abdelrhman1040/Digital-Electronic-Power-Load/Images/schematic/+3V3.png

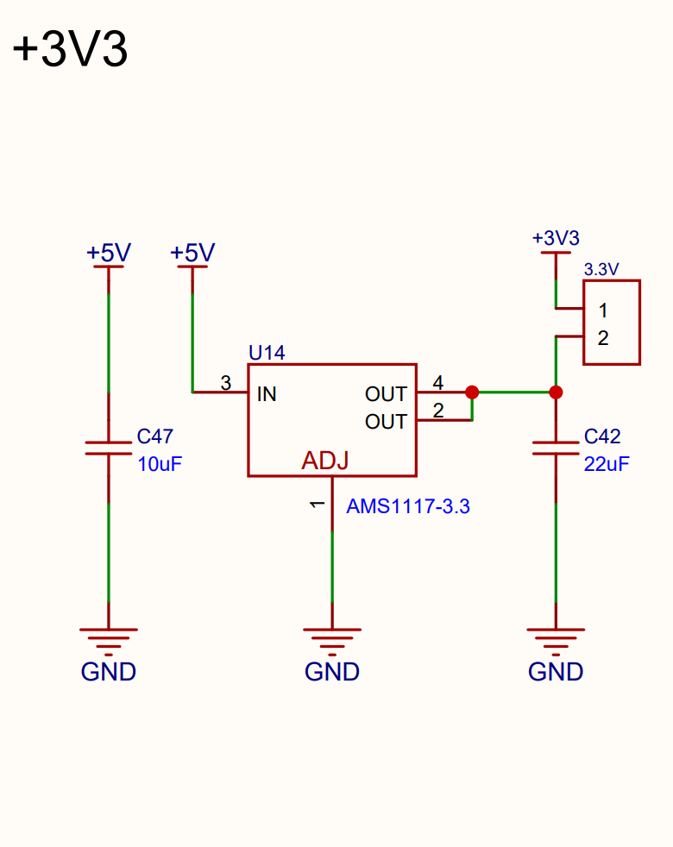
Images/schematic/+3V3.png
