abdelrhman1040/Digital-Electronic-Power-Load/Images/schematic/+5V.png

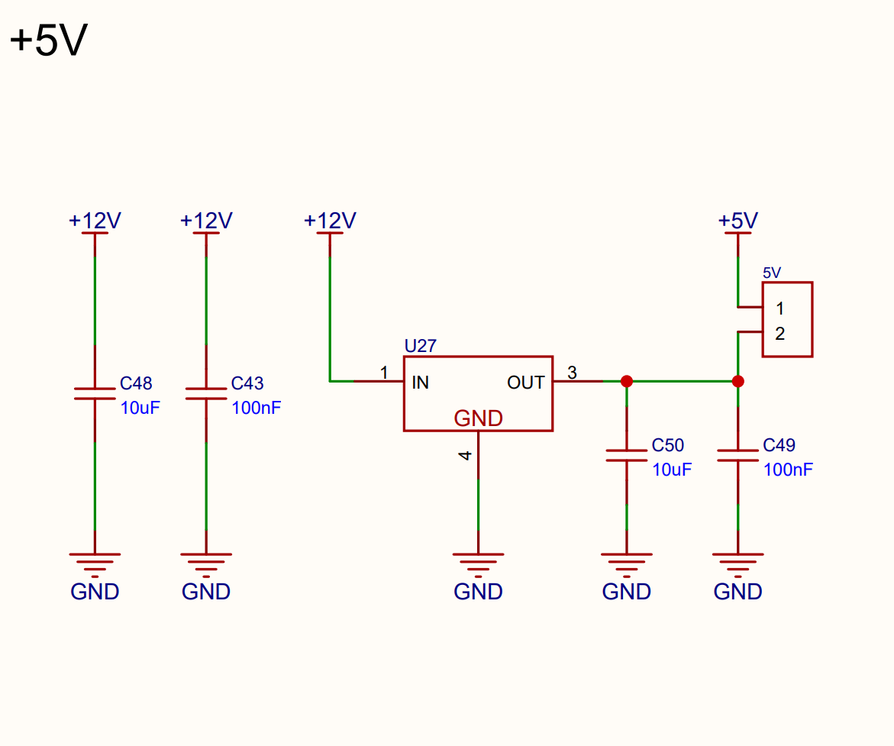
Images/schematic/+5V.png
