abdelrhman1040/Digital-Electronic-Power-Load/Images/schematic/DC.png

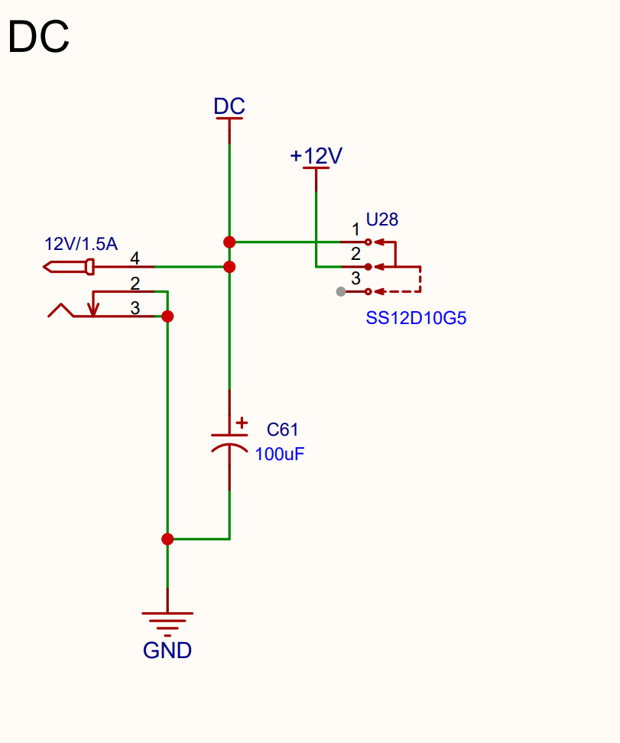
Images/schematic/DC.png
