abdelrhman1040/Digital-Electronic-Power-Load/Images/schematic/LEDs.png

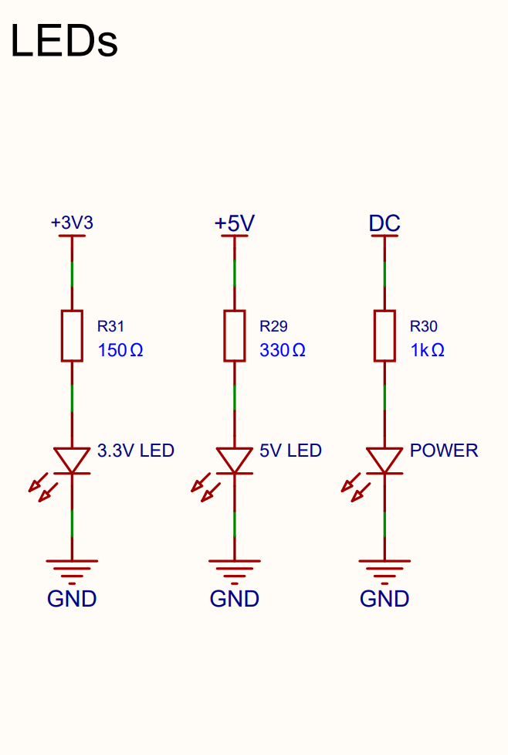
Images/schematic/LEDs.png
