abdelrhman1040/Digital-Electronic-Power-Load/Images/schematic/power_stage.png

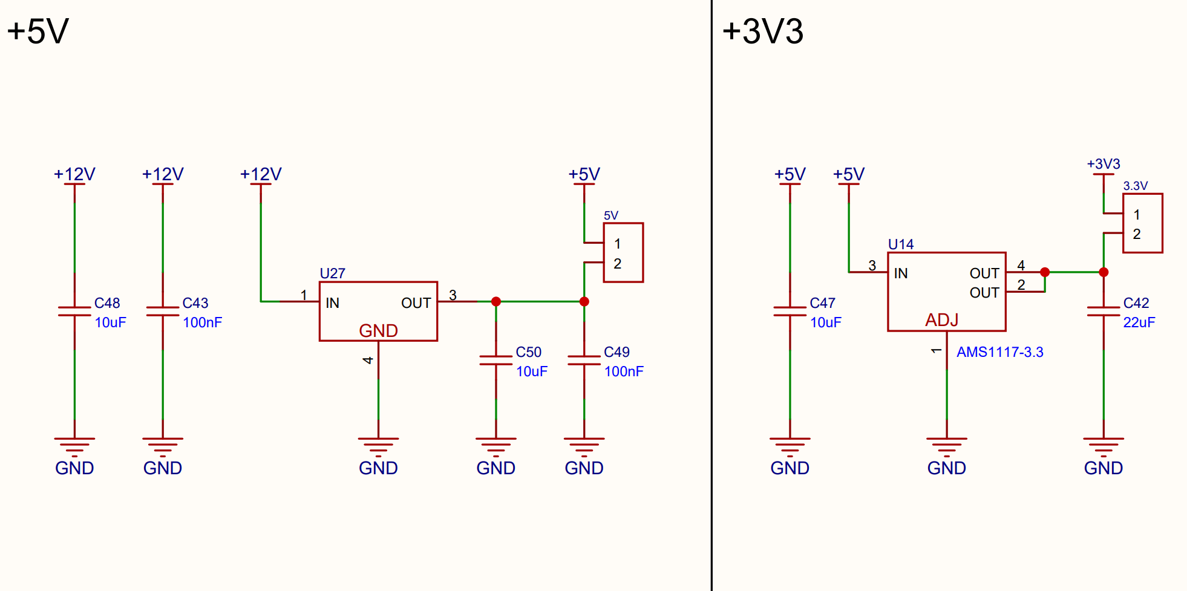
Images/schematic/power_stage.png
