abdelrhman1040/Digital-Electronic-Power-Load/Images/schematic/SD_Card.png

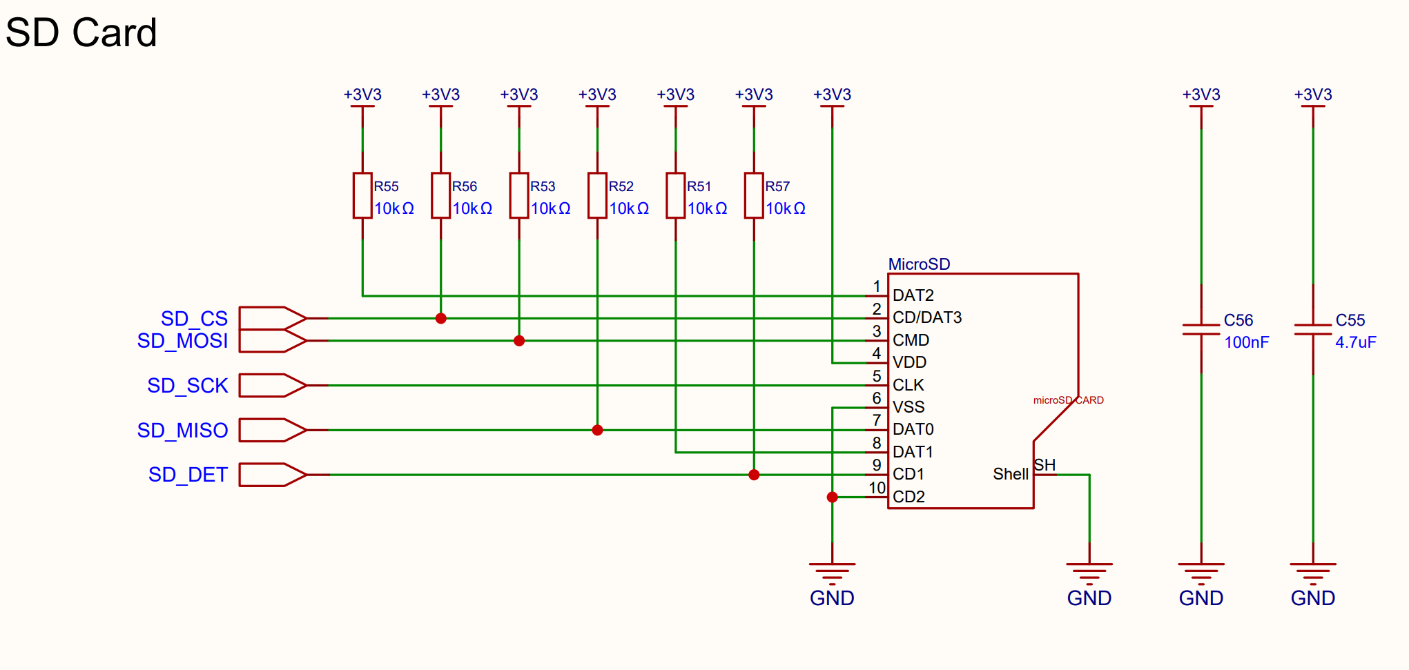
Images/schematic/SD_Card.png
