abdelrhman1040/Digital-Electronic-Power-Load/Hardware/schematic/Schematic.pdf

# STM32

# GNDVIN

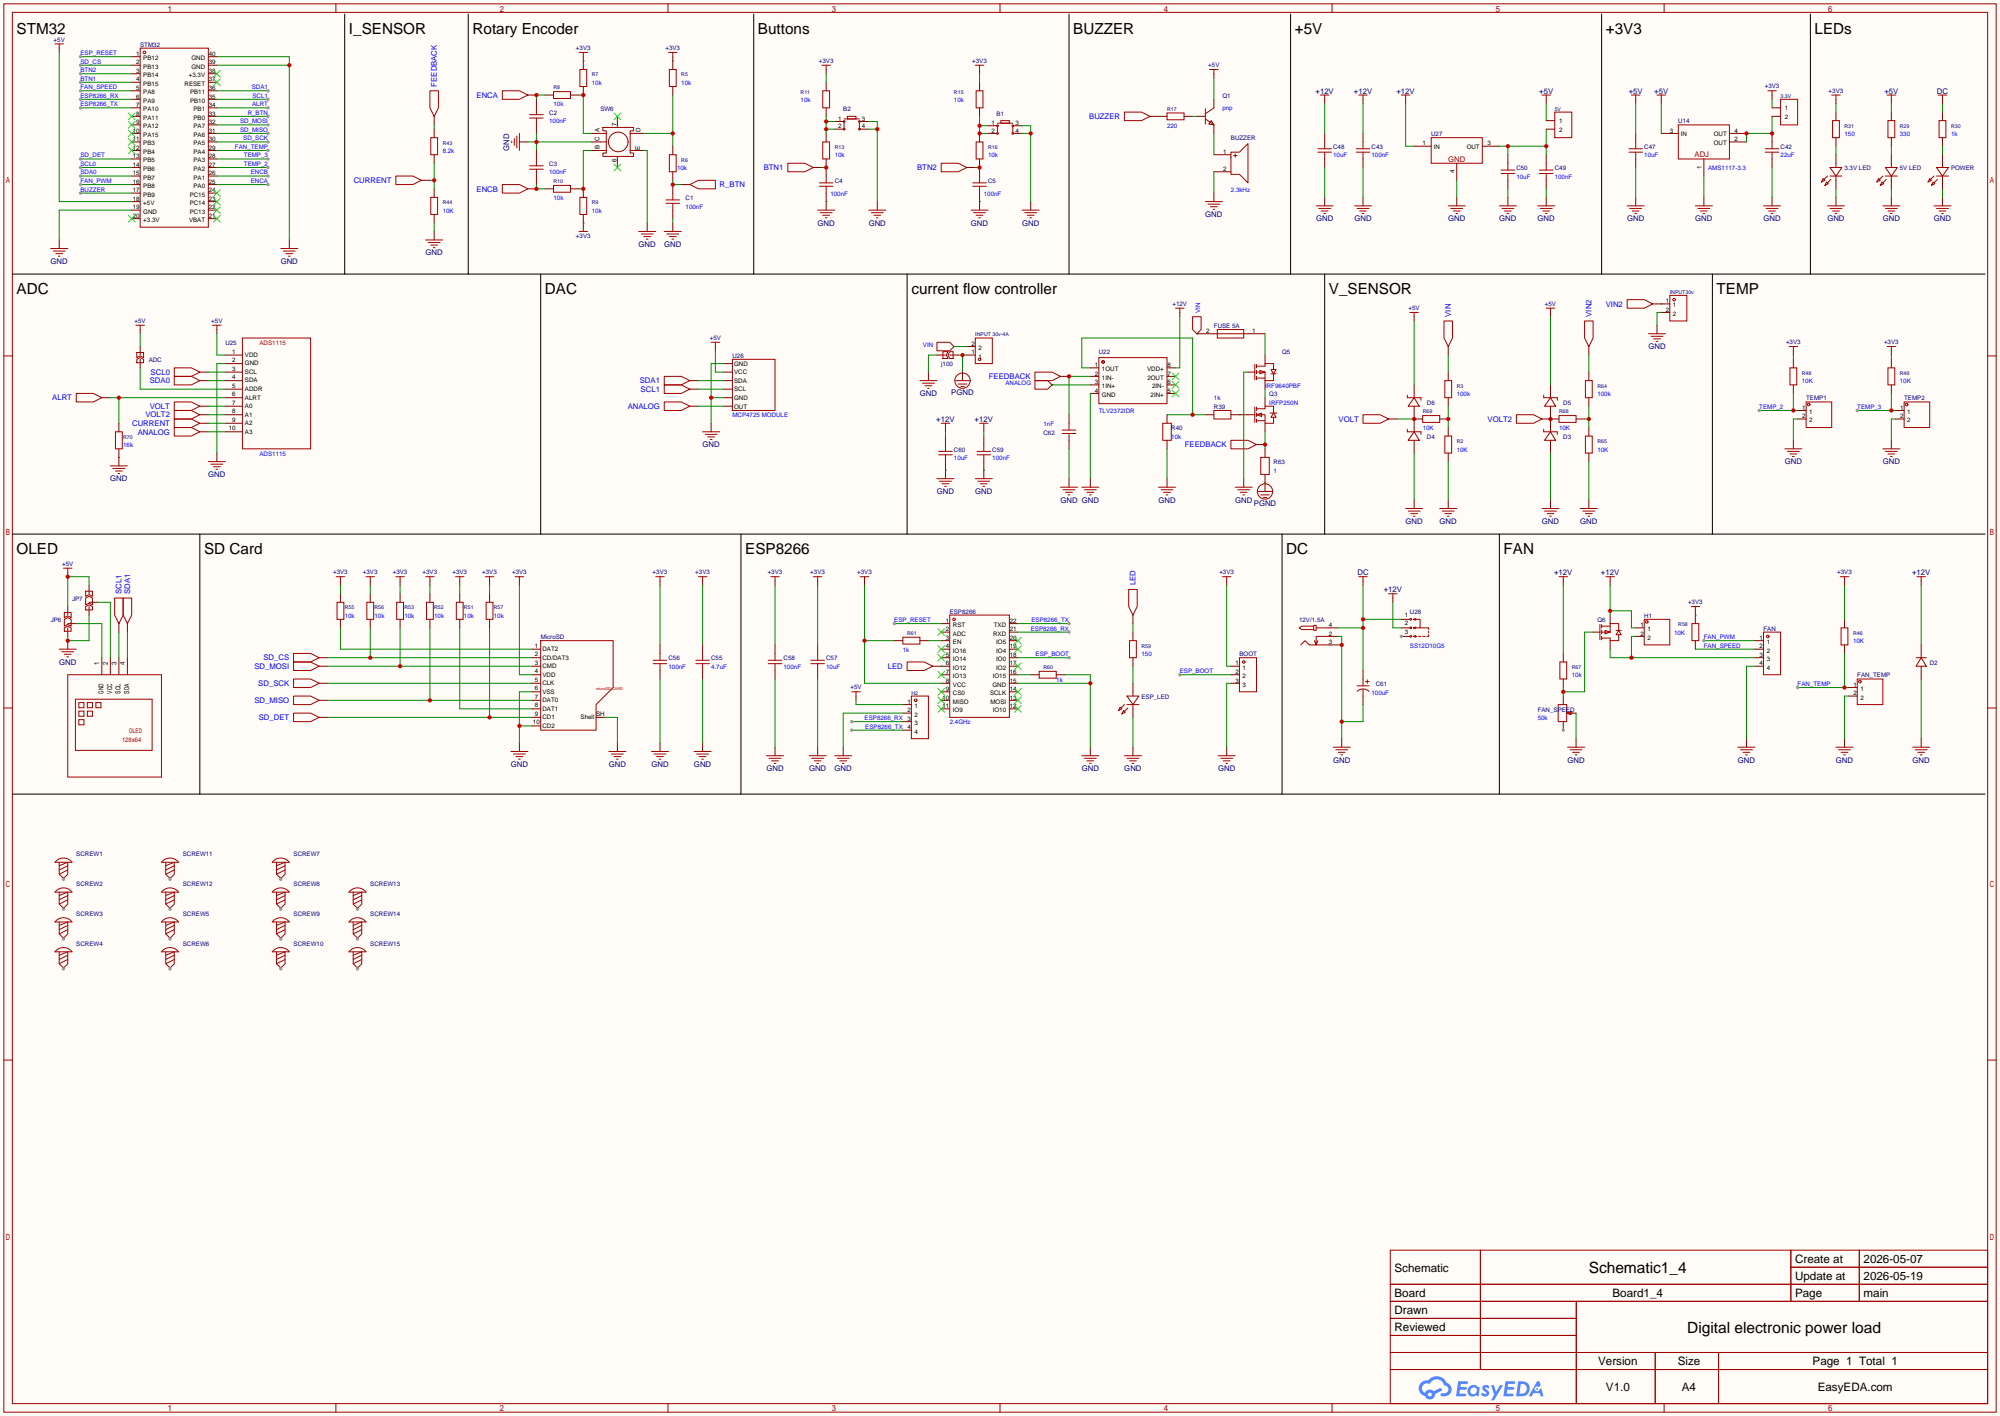
[picture p24: page 1]

Schematic | Schematic1_4 | Create at | 2026-05-07

Update at | 2026-05-19

Board | Board1_4 | Page | main
Drawn | | Digital electronic power load
Reviewed

Version | Size | Page 1 Total 1
V1.0 | A4 | EasyEDA.com
