abdelrhman1040/Digital-Electronic-Power-Load/Core/Inc/main.h

#define ENCA_Pin GPIO_PIN_0
#define ENCA_GPIO_Port GPIOA
#define ENCB_Pin GPIO_PIN_1
#define ENCB_GPIO_Port GPIOA
#define Temp1_Pin GPIO_PIN_2
#define Temp1_GPIO_Port GPIOA
#define Temp2_Pin GPIO_PIN_3
#define Temp2_GPIO_Port GPIOA
#define R_BTN_Pin GPIO_PIN_0
#define R_BTN_GPIO_Port GPIOB
#define R_BTN_EXTI_IRQn EXTI0_IRQn
#define ALRT_Pin GPIO_PIN_1
#define ALRT_GPIO_Port GPIOB
#define ESP_RESET_Pin GPIO_PIN_12
#define ESP_RESET_GPIO_Port GPIOB
#define BTN2_Pin GPIO_PIN_14
#define BTN2_GPIO_Port GPIOB
#define BTN2_EXTI_IRQn EXTI15_10_IRQn
#define BTN1_Pin GPIO_PIN_15
#define BTN1_GPIO_Port GPIOB
#define BTN1_EXTI_IRQn EXTI15_10_IRQn
#define ESP8266_RX_Pin GPIO_PIN_9
#define ESP8266_RX_GPIO_Port GPIOA
#define ESP8266_TX_Pin GPIO_PIN_10
#define ESP8266_TX_GPIO_Port GPIOA
#define FAN_PWM_Pin GPIO_PIN_8
#define FAN_PWM_GPIO_Port GPIOB
#define BUZZER_Pin GPIO_PIN_9
#define BUZZER_GPIO_Port GPIOB
